scotch115/Pathfinder_Avionics/Documentation/Schematics/PCB Design Files/FlightComputer v6.step

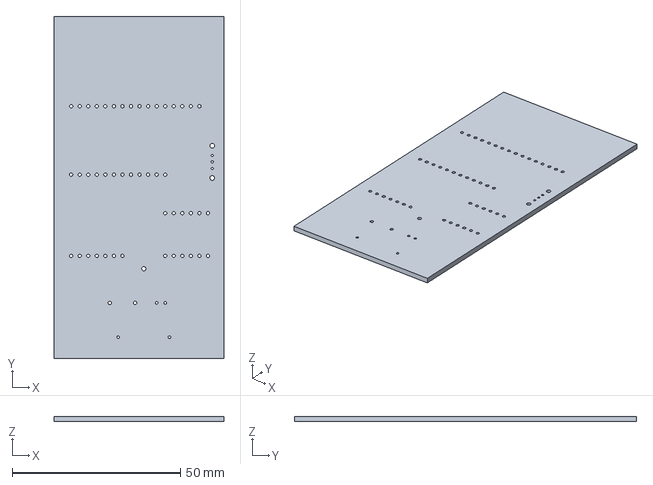
[picture p16: CAD file, 2026-10-30]
Documentation/Schematics/PCB Design Files/FlightComputer v6.step
50.5 x 101.6 x 1.57 mm
