scotch115/Pathfinder_Avionics/src/support/YPR_3D/Rocket.stl

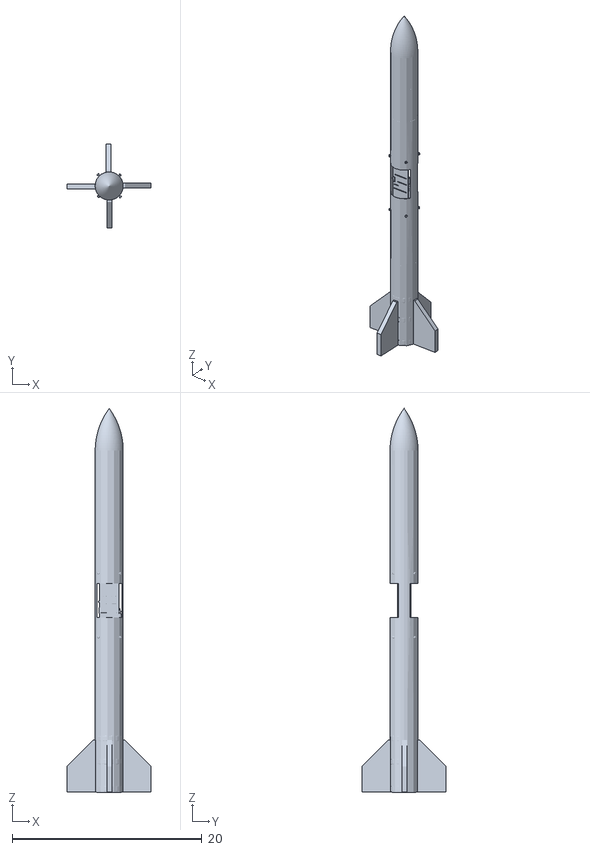
[picture p17: CAD file, 2026-10-30]
src/support/YPR_3D/Rocket.stl
8.89 x 8.89 x 40.5
