scotch115/Pathfinder_Avionics/Documentation/Schematics/PCB Design Files/FlightComputer.dxf

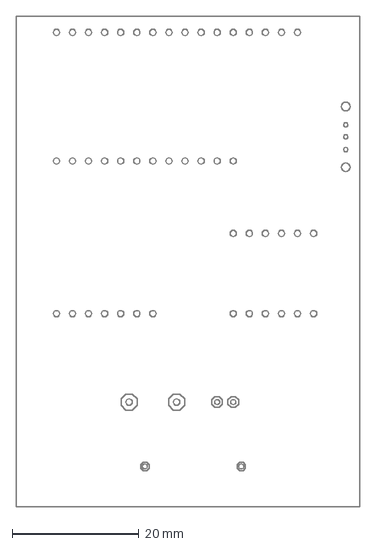
[picture p18: CAD file, 2026-10-30]
Documentation/Schematics/PCB Design Files/FlightComputer.dxf
54.3 x 77.5 mm
