scotch115/Pathfinder_Avionics/(list of files, cad)

Other CAD files:
Documentation/Schematics/Technical Drawings/Servo Mount.dwg
Documentation/Schematics/Technical Drawings/Avionics Payload Mount.dwg
Documentation/Schematics/Technical Drawings/Sled Plate.dwg
src/support/YPR_3D/rocket.obj
