scotch115/Pathfinder_Avionics/Documentation/Schematics/PCB Design Files/FlightComputer.brd

## EAGLE design Documentation/Schematics/PCB Design Files/FlightComputer.brd (2026-10-30)

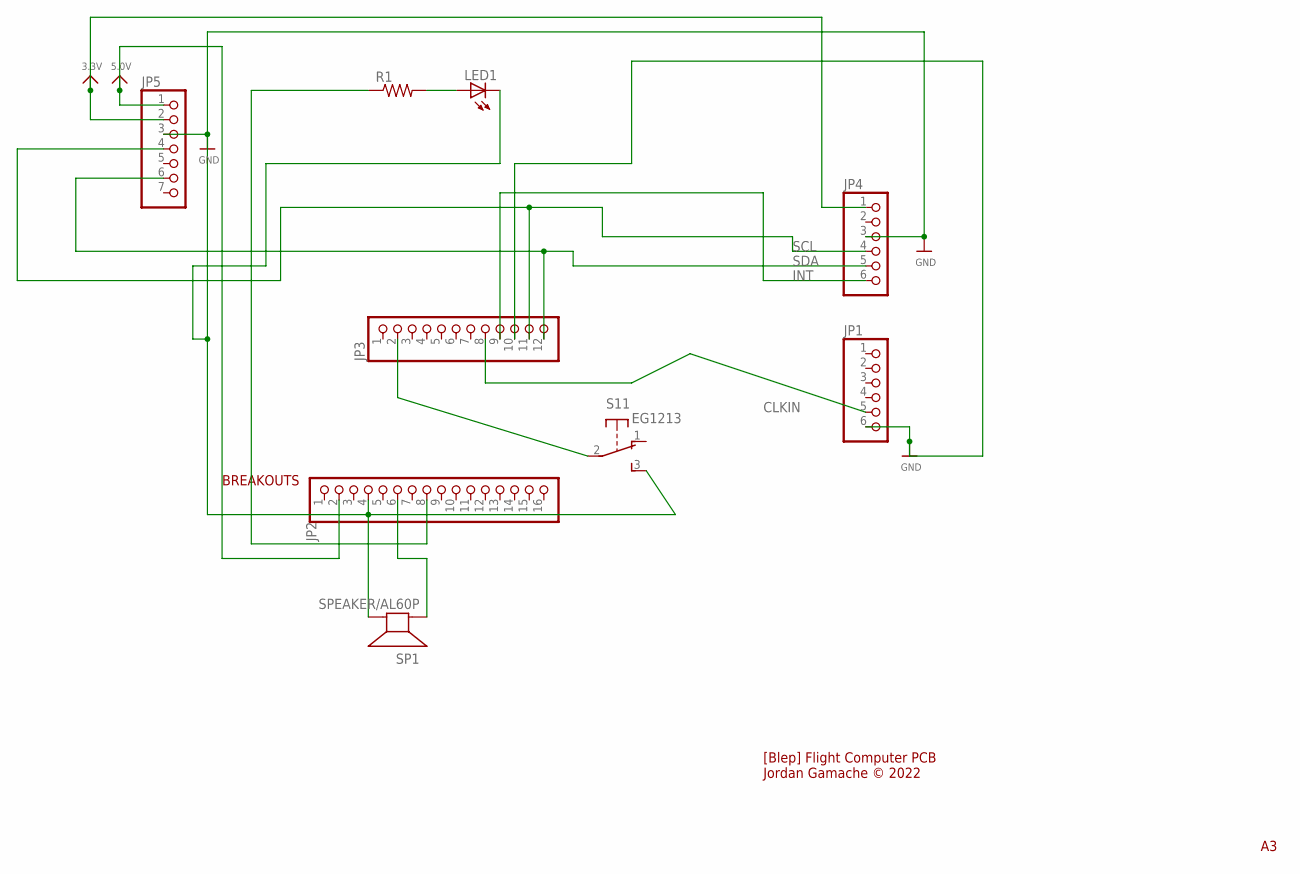
[picture p19: schematic FlightComputer.sch]

Parts:
JP1: HEADER-1X6ROUND; 1X06_ROUND
JP2: HEADER-1X16ROUND; 1X16_ROUND
JP3: HEADER-1X12; 1X12_ROUND
JP4: HEADER-1X670MIL; 1X06_ROUND_70
JP5: HEADER-1X770MIL; 1X07_ROUND_70
LED1: LED5MM
R1: R-US_0207/15; 0207/15
S1: EG1213
SP1: SPEAKER/AL60P; AL60P

Connections:
3.3V: JP4.1, JP5.2
5.0V: JP2.2, JP5.1
CLKIN: JP1.5, JP3.8
GND: JP1.6, JP2.4, JP3.10, JP4.3, JP5.3, LED1.K (C), S1.3 (S), SP1.2 (-)
INT: JP3.9, JP4.6
unnamed: JP2.6, SP1.1 (+)
unnamed: JP2.8, R1.1
unnamed: LED1.A, R1.2
unnamed: JP3.2, S1.2
SCL: JP3.11, JP4.4, JP5.4
SDA: JP3.12, JP4.5, JP5.6

Notes on the sheet:
BREAKOUTS
[Blep] Flight Computer PCB Jordan Gamache © 2022

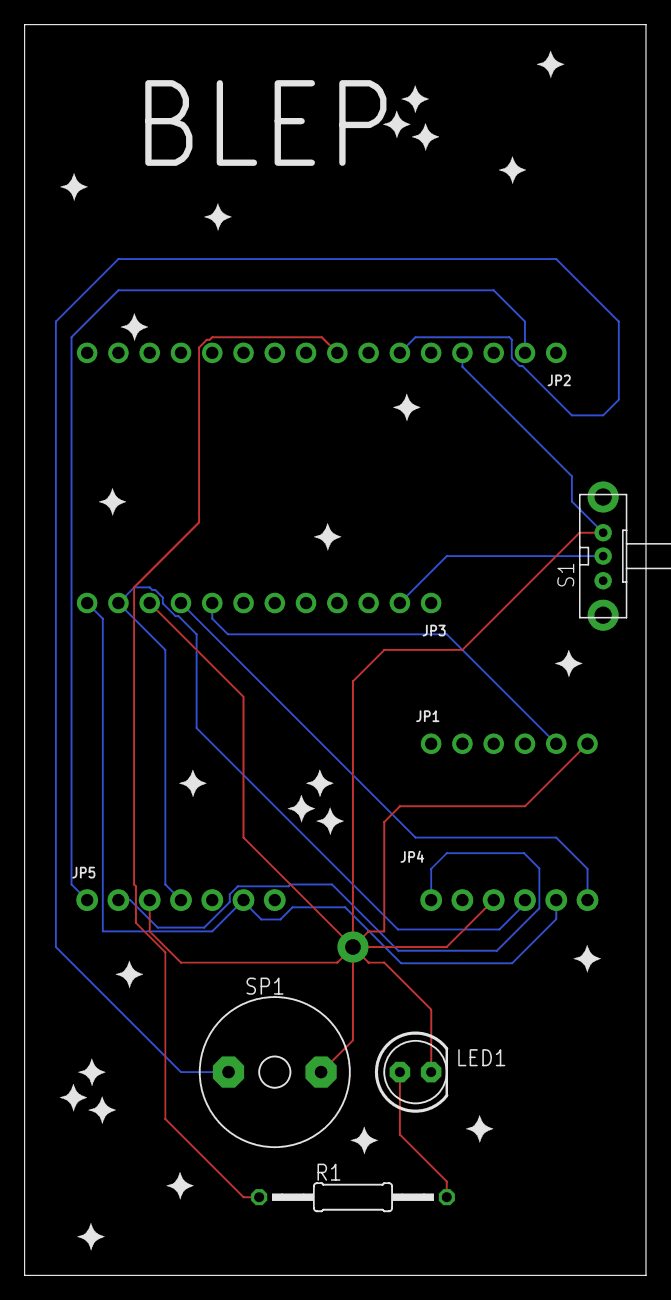
[picture p20: board FlightComputer.brd from above]

Board: 2 copper layers, 50.5 x 101.6 mm, 9 parts (0 on the bottom side), 11 nets.
