scotch115/Pathfinder_Avionics/src/MPU/flightConfiguration.h

// System Settings //
#define debug_state 0
#define mute 0
#define clock_enable 1
// #define verboseLogs 0

// Module Configuration //
#define TELEMETRY 0
#define FIN_TEST 0
#define PYRO1 0
#define RCS 0

// Current Atmospheric Pressure (UPDATE BEFORE FLIGHT)
#define SEALEVELPRESSURE_HPA (1013.25)

#define STARTLAUNCHSTATE STARTUP
