scotch115/Pathfinder_Avionics/src/SPU/flightConfiguration.h

#define debugState "ON"
#define verboseLogs false

/** TELEMETRY OPTIONS
 * @param ACTIVE - send data over LoRaWAN
 * @param LOCAL - send data over WiFi
 * @param INACTIVE - disable remote communications entirely
 */
#define TELEMETRY "ACTIVE"

#define STARTLAUNCHSTATE STARTUP
