scotch115/Pathfinder_Avionics/src/MPU/pbit.h

/***********************************************************************************************/
/*********************************** Power-on Built In Test   **********************************/
/***********************************************************************************************/
void pbit() {
  vehicleState = STARTUP;
  
  Serial.println("+-----------------+");
  Serial.println("| FLIGHT CONFIG   |");
  Serial.println("+-----------------+");
  Serial.print("| debug_state : ");Serial.print(debug_state);Serial.println(" |");
  Serial.print("| mute        : ");Serial.print(mute);Serial.println(" |");
  Serial.print("| CLK_Enable  : ");Serial.print(clock_enable);Serial.println(" |");
  Serial.print("| TELEMETRY   : ");Serial.print(TELEMETRY);Serial.println(" |");
  Serial.print("| FIN_TEST    : ");Serial.print(FIN_TEST);Serial.println(" |");
  Serial.print("| PYRO_CH1    : ");Serial.print(PYRO1);Serial.println(" |");
  Serial.print("| RCS ACTIVE  : ");Serial.print(RCS);Serial.println(" |");
  Serial.println("+-----------------+");

  #if (debug_state == 1)
    Serial.println(); Serial.println();
    Serial.println("Beginning Pre-Flight Software check.");
    Serial.println();
    Serial.print("Flight Computer State: ");Serial.println(vehicleState);
  #endif

  // WIP
  // delay(200);
  // continuity(LEDPIN, 1);
  // delay(200);
  // continuity(BUZZER_PIN, 0);

  pinMode(LEDPIN, OUTPUT);

  // Play bootup sequence sound
  #if (mute == 0)
    for (unsigned int i = 0; i < numTones; i++) {
      tone(BUZZER_PIN, tones[i]);
      delay(50);
    }
    noTone(BUZZER_PIN);
  #endif
  delay(2000);

  #if (debug_state == 1)
    Serial.print("Let's see if the BME280 Barometer/Altimeter is connected. Standby");
    delay(500);
    Serial.print(".");
    delay(500);
    Serial.print(".");
    delay(500);
    Serial.println(".");
  #else
    delay(1500); // Maintain minimal delay to allow for sensor initialization.
  #endif

  // Initialize and test BME280
  if (!bme.begin()) { // I2C address is 0x76
    #if (debug_state == 1)
      Serial.println("Could not find a valid BME280 sensor, check wiring, address, sensor ID!");
    #endif
    vehicleState = ERROR;
  } else {
    String bmeMsg = "Found the BME280 sensor! Here's some data...";
    // TODO - IF we want to save these messages to the SD card, we can implement
    // a Wire.beginTransmission here, but we don't need that for now
    delay(2000);

    #if (debug_state == 1)
      Serial.println(bmeMsg);
      Serial.print("Temperature = "); Serial.print(bme.readTemperature()); Serial.println(" *C");
      Serial.print("Pressure = "); Serial.print((bme.readPressure() / 100.0F)); Serial.println(" Pa"); // Need to update this to kPa to not break PDTP
      Serial.print("Approx Altitude = "); Serial.print(bme.readAltitude(SEALEVELPRESSURE_HPA)); Serial.println(" m");
      Serial.print("Humidity = "); Serial.print(bme.readHumidity()); Serial.println(" %");
      Serial.println();
    #endif

    blep(BUZZER_PIN, 523, 50);

  }
  #if (debug_state == 1)
    Serial.print("Now we'll look for the MPU6050 IMU. Standby");
    delay(500);
    Serial.print(".");
    delay(500);
    Serial.print(".");
    delay(500);
    Serial.println(".");
  #else 
    delay(1500); // Maintain delay for sensor initialization.
  #endif

  // Initialize and test Intertial Measurement Unit (IMU) [MPU6050]
  if (!imu.begin()) { // I2C address is 0x68; can be set to 0x69
    #if (debug_state == 1)
      Serial.println("Could not find a valid MPU6050 sensor, check wiring, address, sensor ID!");
    #endif
    vehicleState = ERROR;
  } else {
    String imuMsg = "Found it! MPU6050 Connection Successful.";
    
    imu.setAccelerometerRange(MPU6050_RANGE_8_G);
    imu.setGyroRange(MPU6050_RANGE_500_DEG);
    imu.setFilterBandwidth(MPU6050_BAND_21_HZ);
    
    blep(BUZZER_PIN, 523, 50);
    delay(50);

    #if (debug_state == 1)
      Serial.println(imuMsg); // TODO - Same as above wrt SD card

      // TODO - Need to add error detection
      // TODO II - Check calibration/settings below
      Serial.print("Accelerometer range set to: ");
      switch (imu.getAccelerometerRange()) {
        case MPU6050_RANGE_2_G:
          Serial.println("+-2G");
          break;
        case MPU6050_RANGE_4_G:
          Serial.println("+-4G");
          break;
        case MPU6050_RANGE_8_G:
          Serial.println("+-8G");
          break;
        case MPU6050_RANGE_16_G:
          Serial.println("+-16G");
          break;
      }
      Serial.print("Gyro range set to: ");
      switch (imu.getGyroRange()) {
        case MPU6050_RANGE_250_DEG:
          Serial.println("+- 250 deg/s");
          break;
        case MPU6050_RANGE_500_DEG:
          Serial.println("+- 500 deg/s");
          break;
        case MPU6050_RANGE_1000_DEG:
          Serial.println("+- 1000 deg/s");
          break;
        case MPU6050_RANGE_2000_DEG:
          Serial.println("+- 2000 deg/s");
          break;
      }
      Serial.print("Filter bandwidth set to: ");
      switch (imu.getFilterBandwidth()) {
        case MPU6050_BAND_260_HZ:
          Serial.println("260 Hz");
          break;
        case MPU6050_BAND_184_HZ:
          Serial.println("184 Hz");
          break;
        case MPU6050_BAND_94_HZ:
          Serial.println("94 Hz");
          break;
        case MPU6050_BAND_44_HZ:
          Serial.println("44 Hz");
          break;
        case MPU6050_BAND_21_HZ:
          Serial.println("21 Hz");
          break;
        case MPU6050_BAND_10_HZ:
          Serial.println("10 Hz");
          break;
        case MPU6050_BAND_5_HZ:
          Serial.println("5 Hz");
          break;
      }

      Serial.println(); Serial.println();
      Serial.println("Here's a little bit of data!");
      for (int i = 0; i < 20; i++) {
        imu.getEvent(&a, &g, &temp);

        /* Print out the values */
        Serial.print("Acceleration X: ");
        Serial.print(a.acceleration.x);
        Serial.print(", Y: ");
        Serial.print(a.acceleration.y);
        Serial.print(", Z: ");
        Serial.print(a.acceleration.z);
        Serial.println(" m/s^2");

        Serial.print("Rotation X: ");
        Serial.print(g.gyro.x);
        Serial.print(", Y: ");
        Serial.print(g.gyro.y);
        Serial.print(", Z: ");
        Serial.print(g.gyro.z);
        Serial.println(" rad/s");
  
        Serial.print("Temperature: ");
        Serial.print(temp.temperature);
        Serial.println(" degC");
        delay(10);
        Serial.println(); Serial.println();
      }
    #else 
      for (int i = 0; i < 20; i++) {
        imu.getEvent(&a, &g, &temp);
      } // Maintain 'imu.getEvent()' call
    #endif

    blep(BUZZER_PIN, 523, 50);
  }

  #if (DEFLECTION_TEST == 1)
    delay(2000);
    Serial.println("Now let's test the fins! Connecting to servos to perform Deflection Test, standby...");
    Serial.println();Serial.println();
    // deflectionTest(); //? [WIP]
    blep(BUZZER_PIN, 523, 50);
  #endif

  // If TELEMETRY value is not accurately set, abort the flight program.
  if (TELEMETRY > 1 || TELEMETRY < 0) {
    vehicleState = ERROR;
  }

  #if (TELEMETRY == 1) 
    Serial.println();
    Serial.println("LoRa Radio module found!");

    // Reset LoRa Module
    digitalWrite(RFM95_RST, LOW);
    delay(10);
    digitalWrite(RFM95_RST, HIGH);
    delay(10);

    while (!rf95.init()) {
      Serial.println("LoRa radio init failed");
      Serial.println("Uncomment '#define SERIAL_DEBUG' in RH_RF95.cpp for detailed debug info");
      while (1);
    }
    Serial.println("LoRa radio initialized!");

    if (!rf95.setFrequency(RF95_FREQ)) {
      Serial.println("setFrequency failed");
      while (1);
    }
    Serial.print("Frequency set to: "); Serial.println(RF95_FREQ);

    rf95.setTxPower(23, false);
  #endif
  
  if (vehicleState != ERROR) {
    // String readyMsg = "Flight Computer is Armed and Ready!";
    // char rMessage[200];
    // int r = 0;
    // while((r<200)) {
    //   rMessage[r]=readyMsg[r];
    //   r++;
    // }

    if (STARTLAUNCHSTATE != DEBUG) {
      vehicleState = ARMED;
    } else {
      vehicleState = STARTLAUNCHSTATE;
    }

    #if (debug_state == 1)
      Serial.println();
      Serial.print("Flight Computer State: ");Serial.println(vehicleState);

      // Serial.println();Serial.println();
      // Serial.println(rMessage);
      // Serial.println();Serial.println();

        // sendPacket(rMessage);
    #endif
  }

  blep(BUZZER_PIN, 1760, 500);

  //  delay(1000);

  // Prepare Pyro Channel 1 (PYRO_1) for chute charge ignition
  //   if (PYRO1) {
  //     pinMode(PYRO_1, OUTPUT);
  //     digitalWrite(PYRO_1, LOW);
  //   }
  // }
//  readyForLaunch();
}
