scotch115/Pathfinder_Avionics/src/SPU/pbit.h

/***********************************************************************************************/
/*********************************** Power-on Built In Test   **********************************/
/***********************************************************************************************/
void preCheck() {
  if (!SD.begin(CS)) {
    Serial.println("SD Card initialization failed!");
    while (true);
  }
  if (TELEMETRY == "ACTIVE") {
    pinMode(RFM95_RST, OUTPUT);
    digitalWrite(RFM95_RST, HIGH);
    delay(100);

    // manual reset
    digitalWrite(RFM95_RST, LOW);
    delay(10);
    digitalWrite(RFM95_RST, HIGH);
    delay(10);

    while (!rf95.init()) {
      Serial.println("LoRa radio init failed");
      Serial.println("Uncomment '#define SERIAL_DEBUG' in RH_RF95.cpp for detailed debug info");
      while (1);
    }
    Serial.println("LoRa radio init OK!");

    // Defaults after init are 434.0MHz, modulation GFSK_Rb250Fd250, +13dbM
    if (!rf95.setFrequency(RF95_FREQ)) {
      Serial.println("setFrequency failed");
      while (1);
    }
    Serial.print("Set Freq to: "); Serial.println(RF95_FREQ);
    // Defaults after init are 434.0MHz, 13dBm, Bw = 125 kHz, Cr = 4/5, Sf = 128chips/symbol, CRC on

    // The default transmitter power is 13dBm, using PA_BOOST.
    // If you are using RFM95/96/97/98 modules which uses the PA_BOOST transmitter pin, then 
    // you can set transmitter powers from 5 to 23 dBm:
    rf95.setTxPower(23, false);
  }

  Serial.begin(115200);

  // Wait for serial to be available if board is in 'DEBUG' mode
  if (debugState == "ON") {
    while (!Serial) {
    }
  }
}
