scotch115/Pathfinder_Avionics/(commit log)

2024-11-03 Created documentation and implemented PDTP (see docs) + code cleanup
    [Avionics Payload Mount.dwg, FlightComputer v6.step, FlightComputer.brd, FlightComputer.dxf, FlightComputer.sch, Rocket.stl, Servo Mount.dwg, Sled Plate.dwg]
2026-10-30 Repository cleanup
    [Avionics Payload Mount.dwg, FlightComputer v6.step, FlightComputer.brd, FlightComputer.dxf, FlightComputer.sch, Servo Mount.dwg, Sled Plate.dwg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]
2026-11-12 Adding AELD driver support
2026-11-13 Incremental driver code development
2026-11-13 Completed PDTP updates to support Linux driver usage.
