scotch115/Pathfinder_Avionics/Documentation/Images/PCB-test.PNG

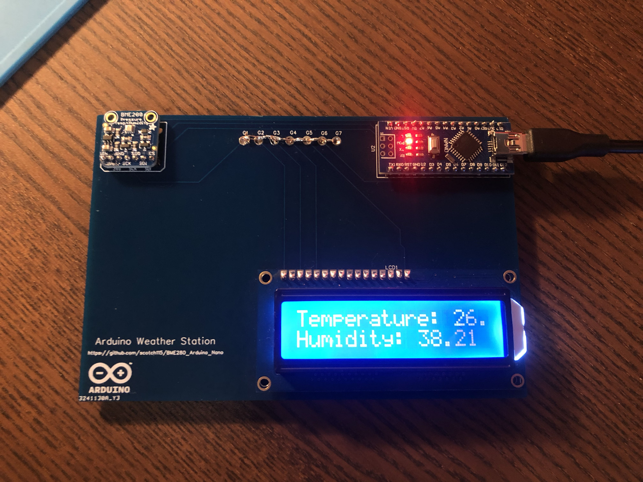
[picture p6: Documentation/Images/PCB-test.PNG]
Documentation/Images/PCB-test.PNG
