scotch115/Pathfinder_Avionics/Documentation/Images/flightCPU.PNG

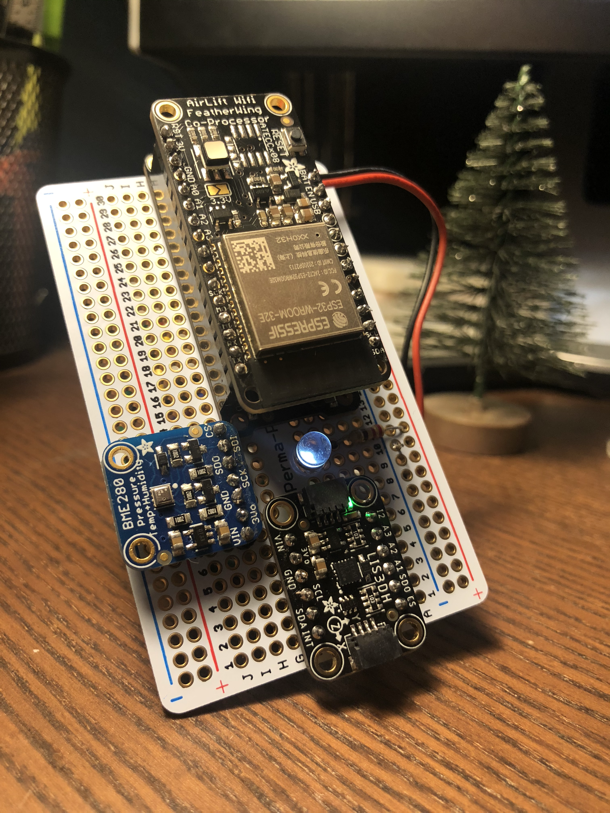
[picture p7: Documentation/Images/flightCPU.PNG]
Documentation/Images/flightCPU.PNG
