scotch115/Pathfinder_Avionics/Documentation/Images/groundCtrl.PNG

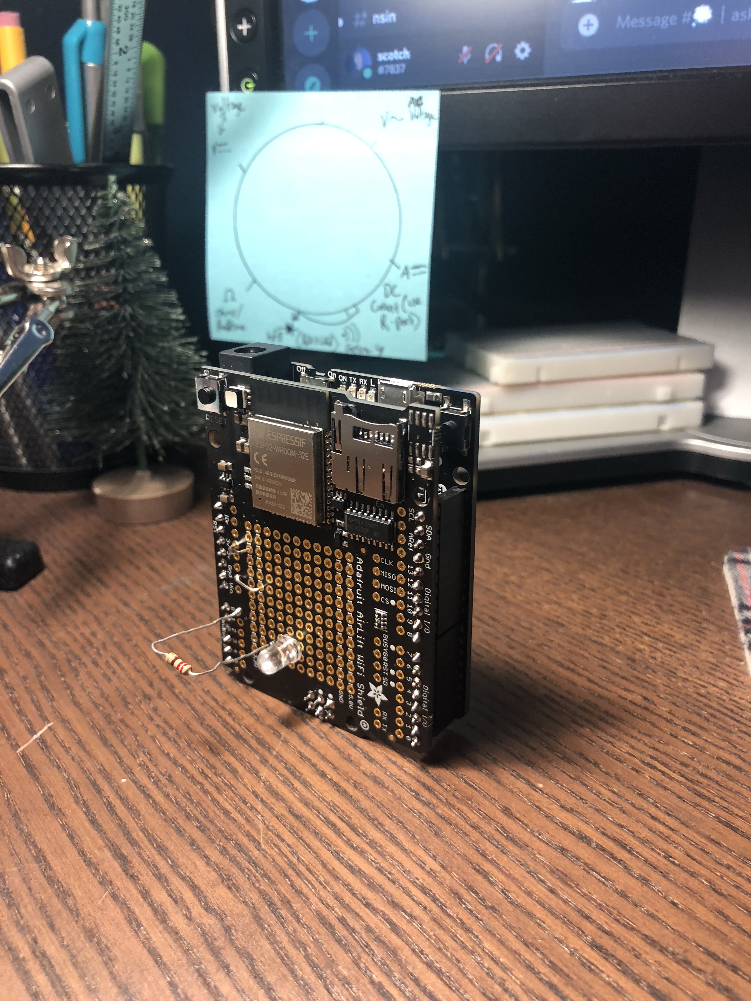
[picture p8: Documentation/Images/groundCtrl.PNG]
Documentation/Images/groundCtrl.PNG
